djgrasss/MARK/literature/Brainstorming session 2.jpg

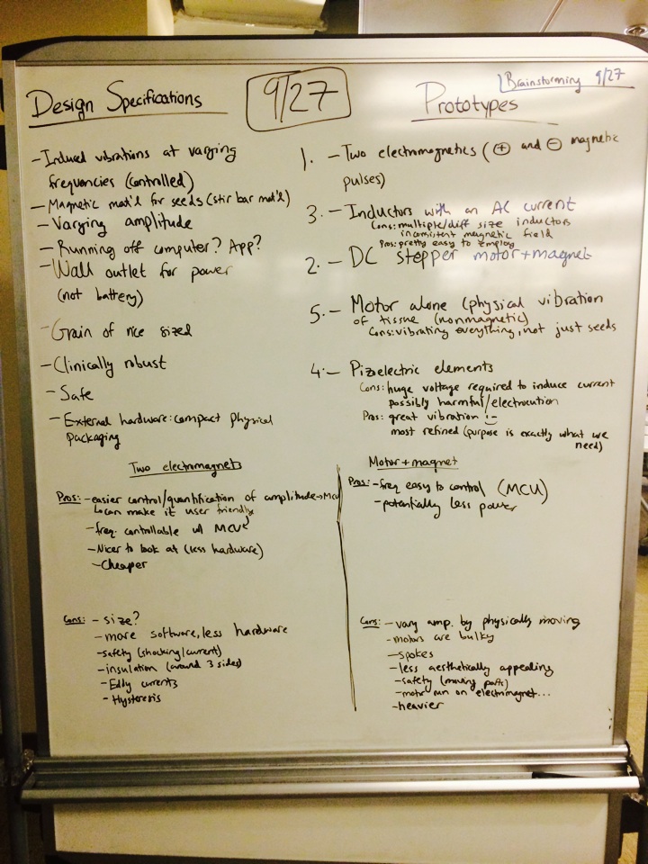
literature/Brainstorming session 2.jpg
