djgrasss/MARK/literature/20141203_085435.jpg

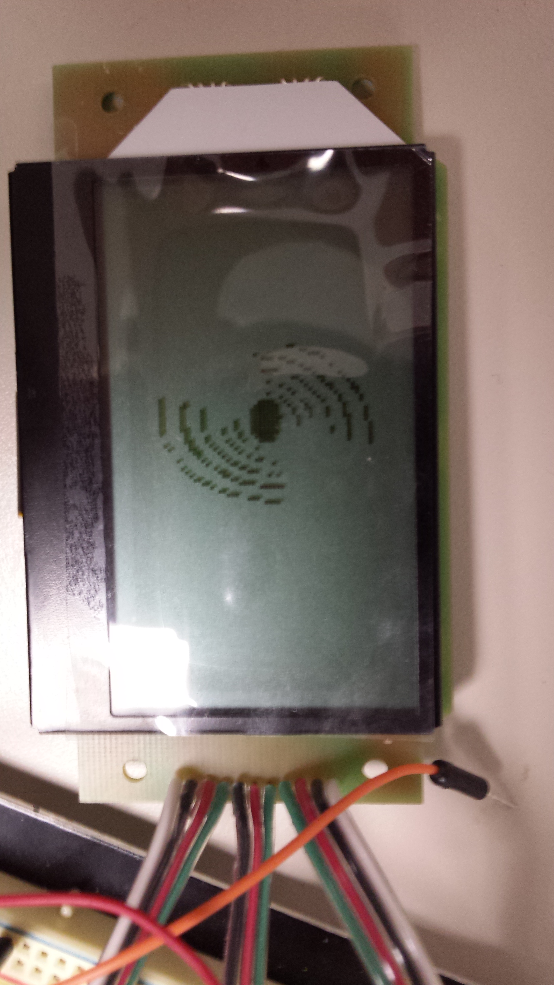
literature/20141203_085435.jpg
