djgrasss/MARK/README.md

MARK
====

Multi-Spectral Prostate Brachyseed Oscillator
-------------------------------------------

Team Roles
----------
 * Software: Michael
 * Testing: Ananya
 * Hardware: Rhea
 * Physical Design: Karthika
