djgrasss/MARK/RelevantLiterature.md

Relevant Literature
===================

Some literature worth considering in your research of the clinical motivation
for this project:

 * Chen, S., Fatemi, M., & Greenleaf, J. F. (2002). Remote measurement of
   material properties from radiation force induced vibration of an embedded
   sphere. Journal of the Acoustical Society of America, 112(3), 884-889.
