djgrasss/MARK/EMF strength analysis data (Design).xlsx

 | Seed distance from magnet (cm) | Observations about seed movement | Current through magnet (A) | mesured EMF field strength (mT) | Calculated field strength (mT)
Trial 1 | 3
Trial 2 | 3
Trial 3 | 3
Average
Trial 1 | 4
Trial 2 | 4
Trial 3 | 4
Average
Trial 1 | 5
Trial 2 | 5
Trial 3 | 5
Average
Trial 1 | 6
Trial 2 | 6
Trial 3 | 6
Average
Trial 1 | 7
Trial 2 | 7
Trial 3 | 7
Average
Trial 1 | 8
Trial 2 | 8
Trial 3 | 8
Average
Trial 1 | 9
Trial 2 | 9
Trial 3 | 9
Average
Trial 1 | 10
Trial 2 | 10
Trial 3 | 10
Average
Trial 1 | 11
Trial 2 | 11
Trial 3 | 11
Average
Trial 1 | 12
Trial 2 | 12
Trial 3 | 12
Average
Trial 1 | 13
Trial 2 | 13
Trial 3 | 13
Average
Trial 1 | 14
Trial 2 | 14
Trial 3 | 14
Average
Trial 1 | 15
Trial 2 | 15
Trial 3 | 15
Average
