djgrasss/MARK/Testing/EMF strength analysis data (Design).xlsx

 | Seed distance from magnet (cm) | Observations about seed movement | Current through magnet (A) | measured EMF field strength (mT) | Calculated field strength (T) | Calculated field strength (mT) | Ratio (measured/calculated)
Trial 1 | 0.5 |  | 1.9 | 3.9 | 0.0025 | 2.5 | 1.56 | Frequency: 5 Hz
Trial 2 | 0.5 |  | 1.92 | 3.92 | 0.0025 | 2.5 | 1.568 | Voltage: 6.02 V
Trial 3 | 0.5 |  | 1.96 | 3.86 | 0.0025 | 2.5 | 1.544
Average | 0.5 |  | 1.926666667 | 3.893333333 | 0.0025 | 2.5 | 1.557333333
Trial 1 | 1 |  | 1.9 | 3.8 | 0.0016 | 1.6 | 2.375
Trial 2 | 1 |  | 1.92 | 3.6 | 0.0017 | 1.7 | 2.117647059
Trial 3 | 1 |  | 1.96 | 3.4 | 0.0017 | 1.7 | 2
Average | 1 |  | 1.926666667 | 3.6 | 0.0017 | 1.666666667 | 2.16
Trial 1 | 1.5 |  | 1.9 | 2.48 | 0.0011 | 1.1 | 2.254545455
Trial 2 | 1.5 |  | 1.92 | 2.35 | 0.0011 | 1.1 | 2.136363636
Trial 3 | 1.5 |  | 1.96 | 2.2 | 0.0011 | 1.1 | 2
Average | 1.5 |  | 1.926666667 | 2.343333333 | 0.0011 | 1.1 | 2.13030303
Trial 1 | 2 |  | 1.9 | 2.1 | 0.0007 | 0.7 | 3
Trial 2 | 2 |  | 1.92 | 2.2 | 0.0008 | 0.8 | 2.75
Trial 3 | 2 |  | 1.96 | 2.01 | 0.0008 | 0.8 | 2.5125
Average | 2 |  | 1.926666667 | 2.103333333 | 0.0008 | 0.7666666667 | 2.743478261
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
