djgrasss/MARK/Design Enclosure Draft.JPG

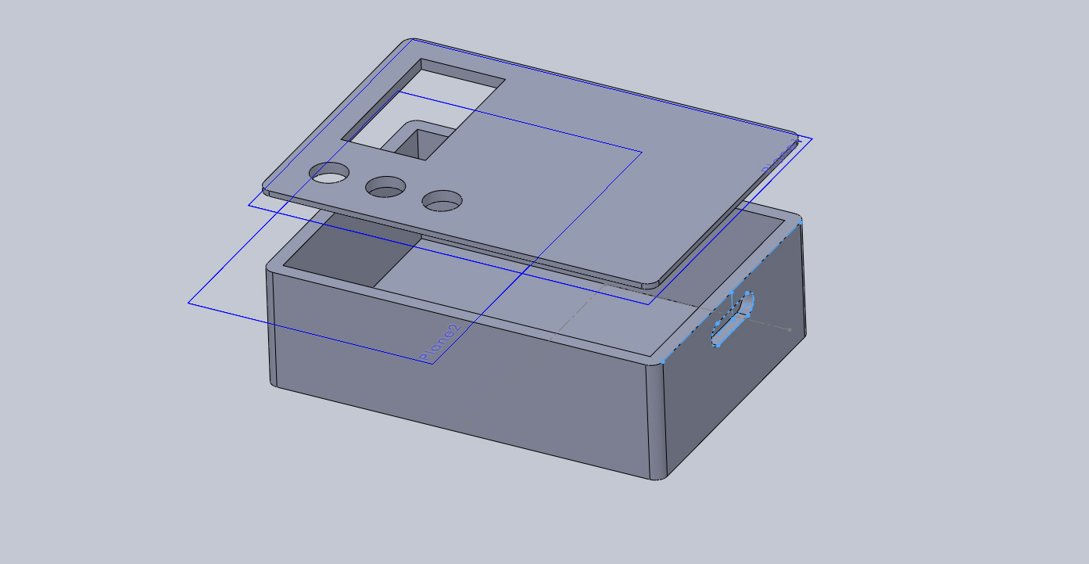
Design Enclosure Draft.JPG
