djgrasss/MARK/DigitalPot2Arduino.jpg

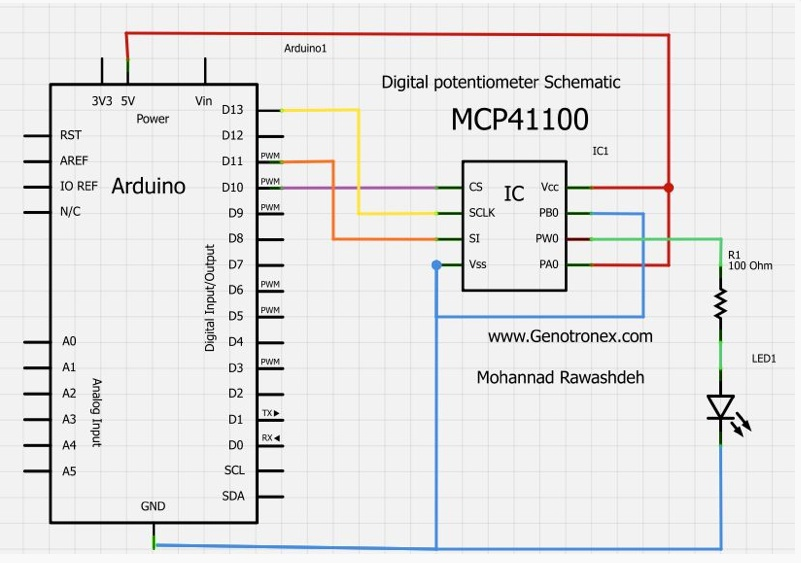
DigitalPot2Arduino.jpg
