djgrasss/MARK/DigitalPot.jpg

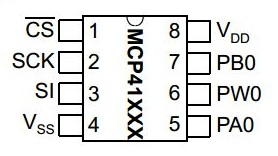
DigitalPot.jpg
