djgrasss/MARK/Flowcharts/jpeg images of flowcharts/draw_backlight.PNG

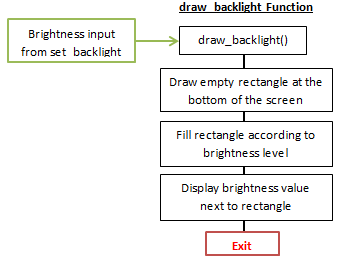
Flowcharts/jpeg images of flowcharts/draw_backlight.PNG
