djgrasss/MARK/Flowcharts/jpeg images of flowcharts/draw_cursor.PNG

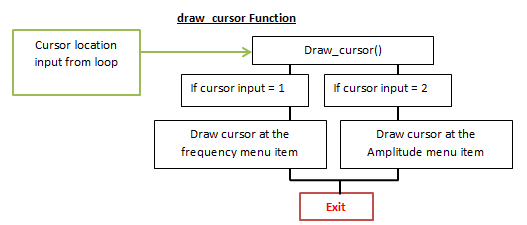
Flowcharts/jpeg images of flowcharts/draw_cursor.PNG
