djgrasss/MARK/Flowcharts/jpeg images of flowcharts/draw_frequency_and_amp.PNG

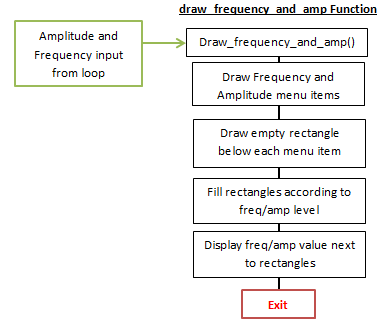
Flowcharts/jpeg images of flowcharts/draw_frequency_and_amp.PNG
