djgrasss/MARK/Flowcharts/jpeg images of flowcharts/general flowchart.PNG

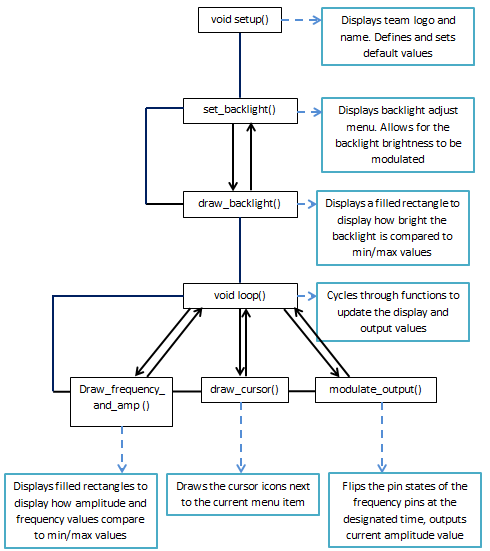
Flowcharts/jpeg images of flowcharts/general flowchart.PNG
