djgrasss/MARK/Flowcharts/jpeg images of flowcharts/loop.PNG

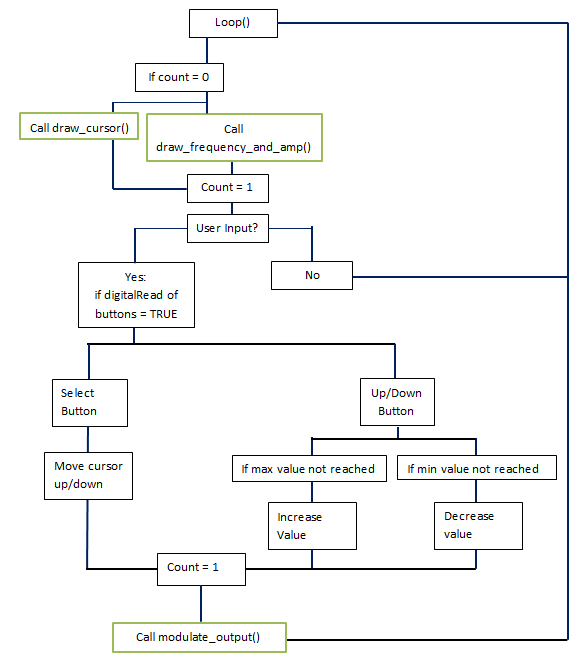
Flowcharts/jpeg images of flowcharts/loop.PNG
