djgrasss/MARK/Flowcharts/jpeg images of flowcharts/modulate_output.PNG

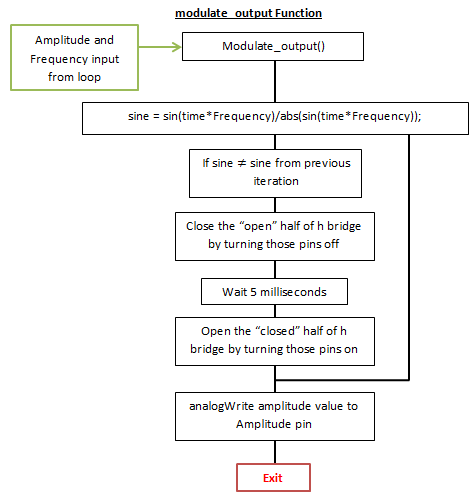
Flowcharts/jpeg images of flowcharts/modulate_output.PNG
