djgrasss/MARK/Flowcharts/jpeg images of flowcharts/set_backlight.PNG

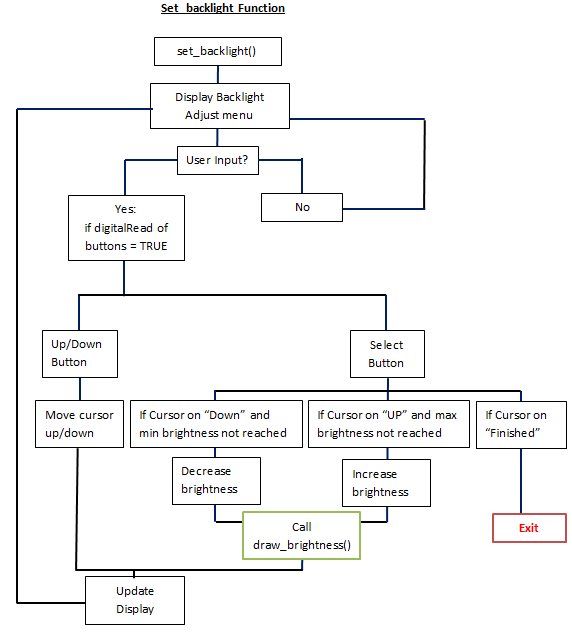
Flowcharts/jpeg images of flowcharts/set_backlight.PNG
