djgrasss/MARK/literature/20141203_085404.jpg

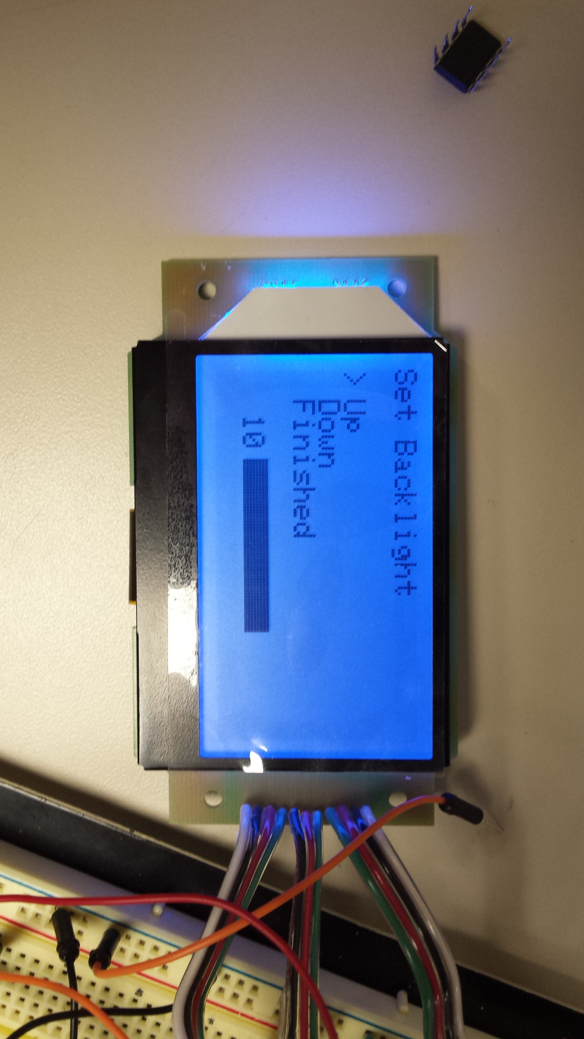
literature/20141203_085404.jpg
