djgrasss/MARK/literature/20141203_085438.jpg

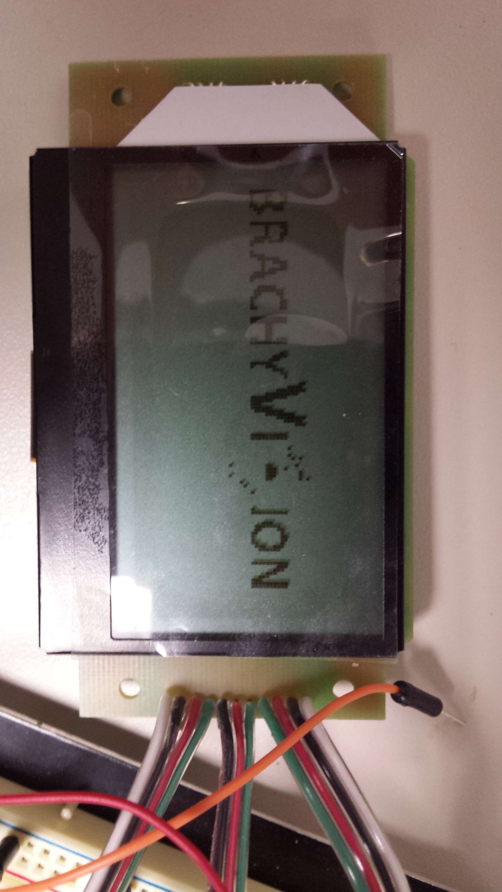
literature/20141203_085438.jpg
