djgrasss/MARK/literature/20141203_085441.jpg

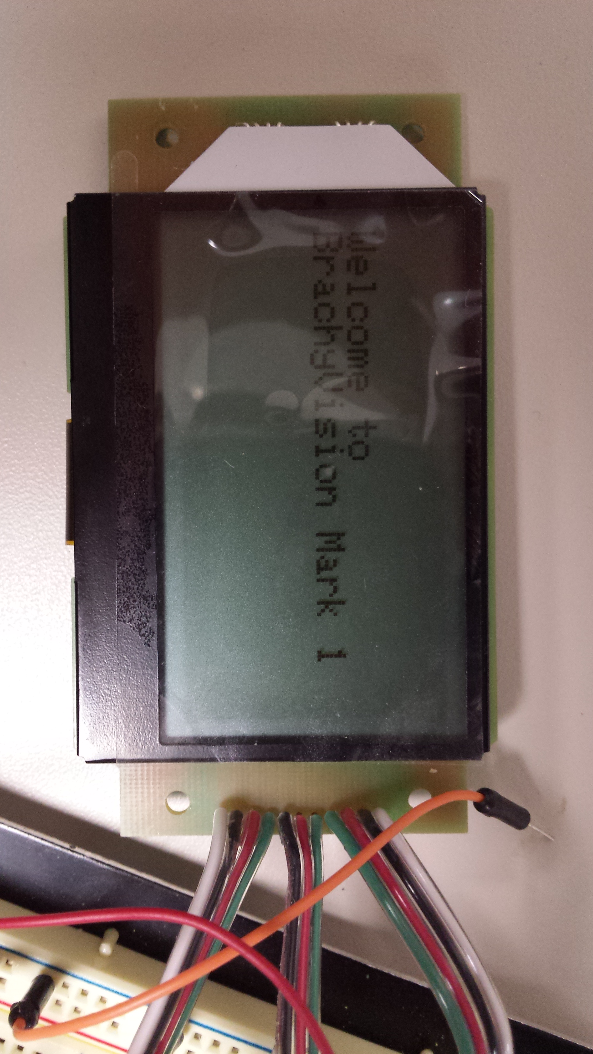
literature/20141203_085441.jpg
