djgrasss/MARK/literature/20141203_085541.jpg

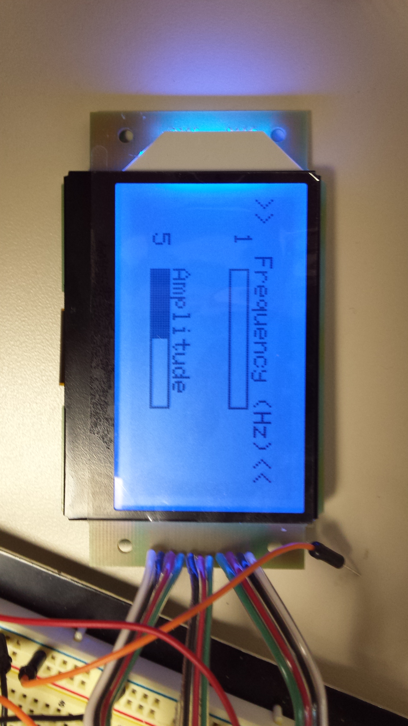
literature/20141203_085541.jpg
