djgrasss/MARK/literature/New LCD Screen.PNG

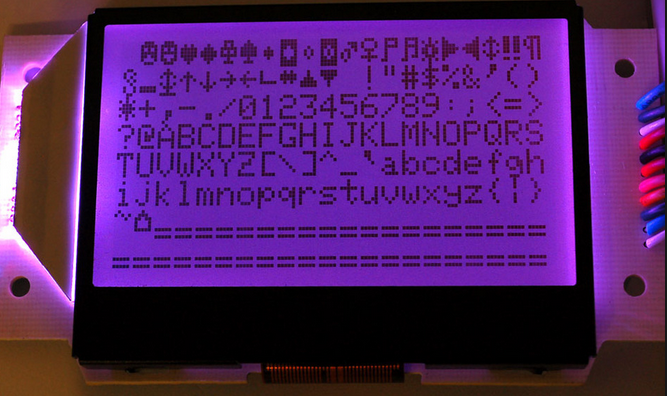
literature/New LCD Screen.PNG
