djgrasss/MARK/Software Flowchart.PNG

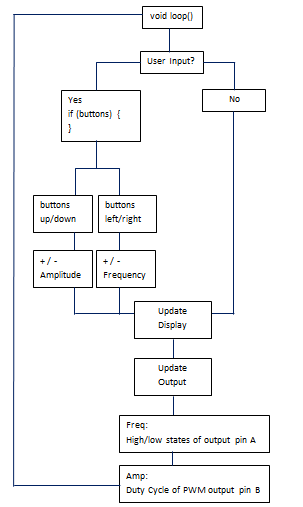
Software Flowchart.PNG
