djgrasss/MARK/Team MARK probe 2.JPG

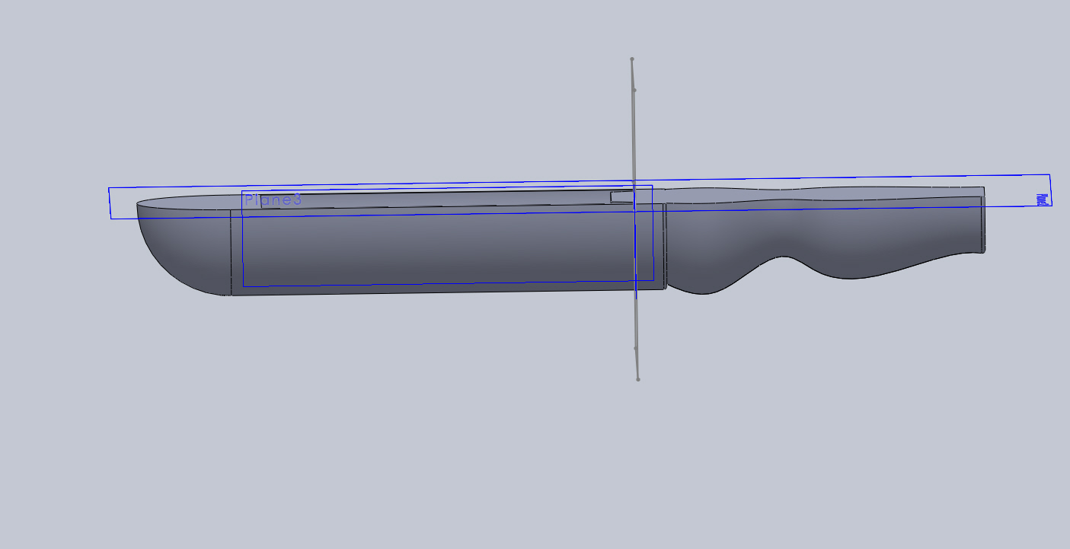
Team MARK probe 2.JPG
