djgrasss/MARK/Team MARK probe 3.JPG

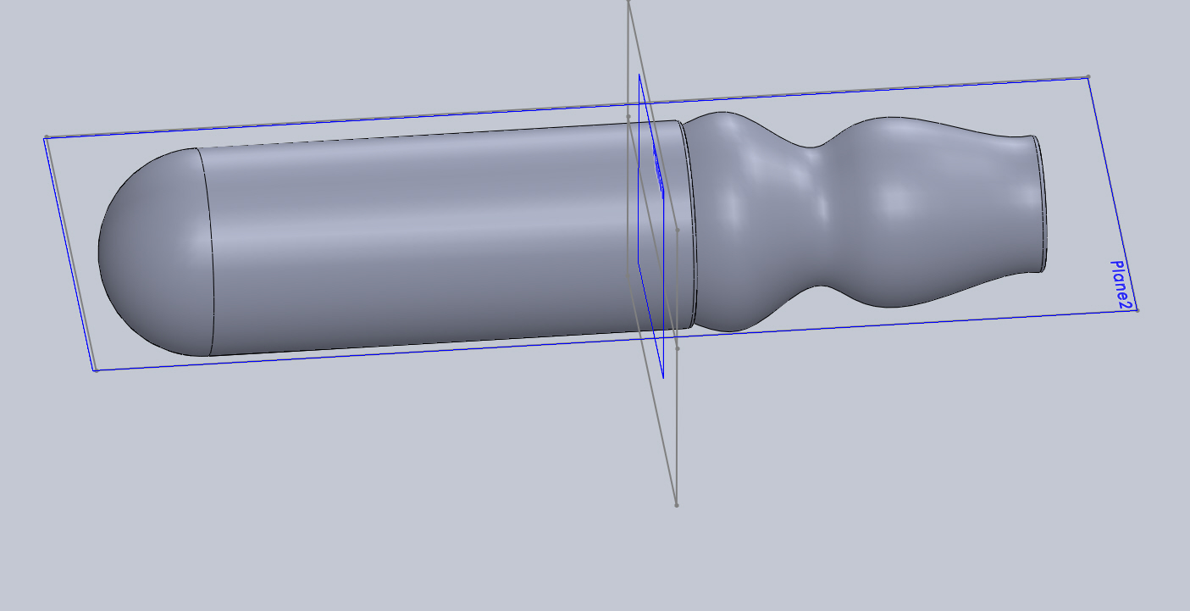
Team MARK probe 3.JPG
