djgrasss/MARK/Team MARK probe.JPG

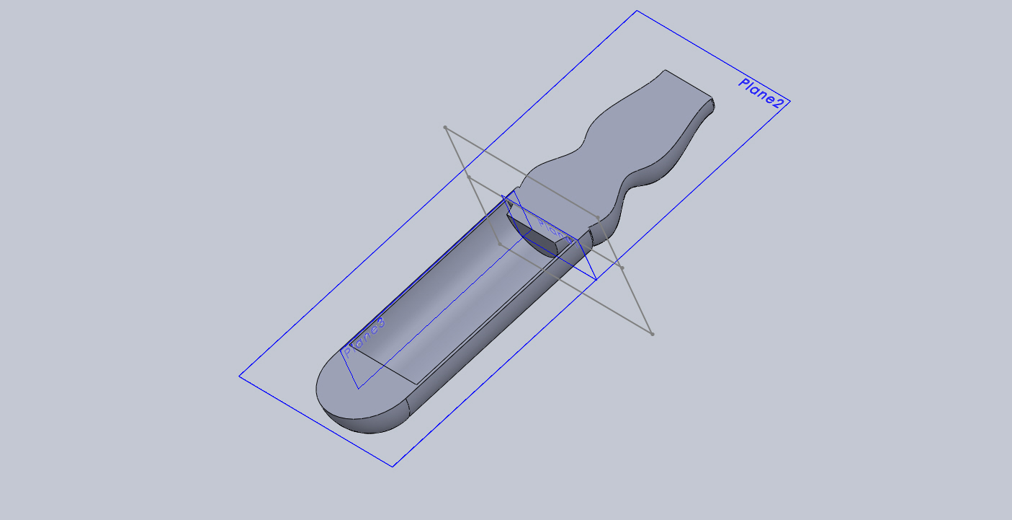
Team MARK probe.JPG
