djgrasss/MARK/Component Order Form.xlsx

Name | Karthika Raja |  |  |  |  |  |  |  | Instructions
Group | Team MARK |  |  |  |  |  |  |  | Orders must be submitted by email by 8pm Thursday evening to nbb5@duke.edu to be processed with the weekly Friday order
Date | 2014-10-09 |  |  |  |  |  |  |  | Preferred vendor is Mouser. Backups are Newark and Digikey. Please check these first for your component - arrangements can be made if your part can only come from another source (e.g. your main sensor)
Vendor | Quantity | Part number | Part Description | Package | Price | Extended Price | URL (if not Mouser) | Notes | When ordering ICs, be particularly careful about package - size of chip and type of pins
Adafruit | 1 | 250 | Graphic ST7565 Positive LCD (128x64) |  | $17.50 | $17.50 | http://www.adafruit.com/products/250 |  | Include units for quantity where necessary (5 resistors vs 5 packs of 25 resistors)
Stirbars.com | 1 pack of 10 bars | SBM-0502-MIC | PTFE Stir Bars - 5 mm x 2mm |  | $26.00 | $26.00 | http://www.stirbars.com/list.php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 |  | Choose the right price for the quantity you are ordering - most companies offer bulk discounts
Stirbars.com | 1 pack of 10 bars | SBM-0303-MIC | PTFE Stir Bars - 3 mm x 3 mm |  | $26.00 | $26.00 | http://www.stirbars.com/list.php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 |  | Extended price is the quantity * price
Mouser | 1 pack 10 potentiometer | 652-3310C-001-204L (http://www.mouser.com/Search/ProductDetail.aspx) | Potentiometers 9mm 200Kohms Single Cup |  | $1.34 | $13.40 |  |  | Include any other necessary notes for Matt to process your order
Heat Sink Factory | 1 |  | AC to DC Adapter - 110V AC to 5V DC Converter w/ Standard 4 Pin (500mA Max) (http://www.heatsinkfactory.com/) |  | $10.75 | $10.75 | http://www.heatsinkfactory.com/ac-to-dc-adapter-110v-ac-to-5v.html
