djgrasss/MARK/Design Enclosure Draft.SLDPRT

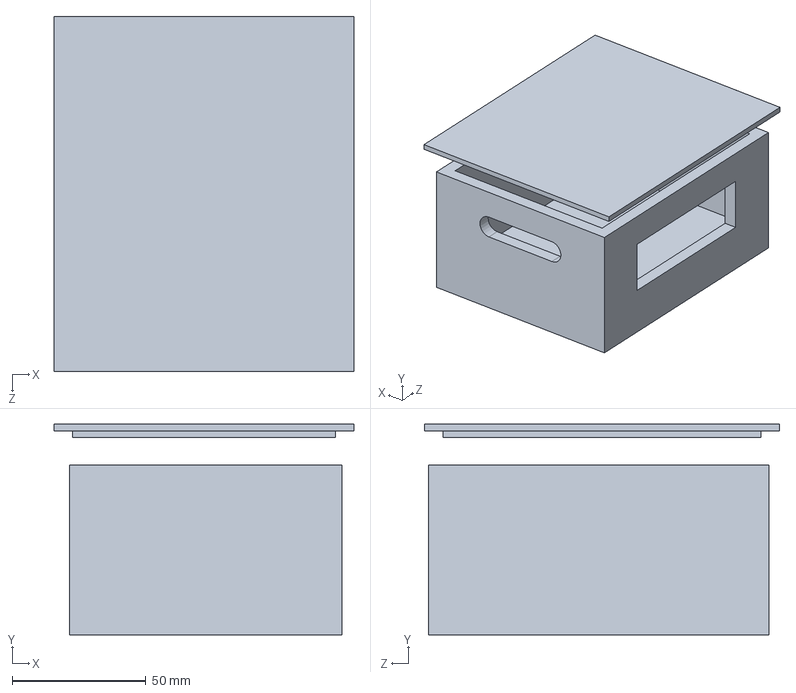
[picture p35: CAD file, 2014-10-10]
Design Enclosure Draft.SLDPRT
111.8 x 78.7 x 132.5 mm
