djgrasss/MARK/FINAL CAD Drawings/Team MARK Probe Part 1.SLDPRT

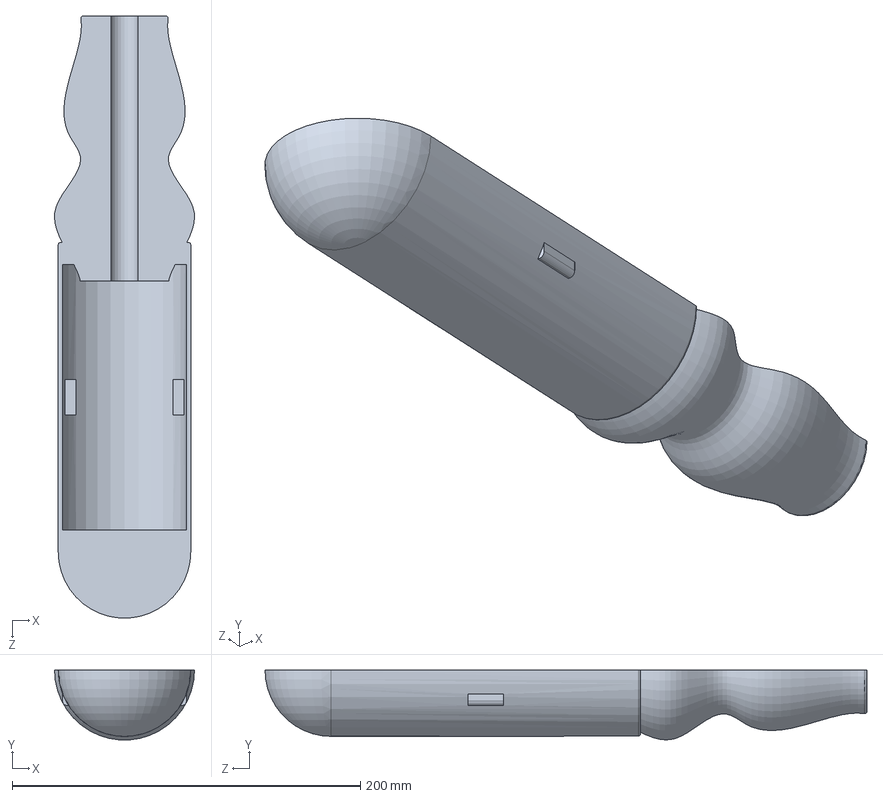
[picture p36: CAD file, 2014-11-16]
FINAL CAD Drawings/Team MARK Probe Part 1.SLDPRT
80.5 x 40.1 x 345.9 mm
