djgrasss/MARK/Design Probe Draft.SLDPRT

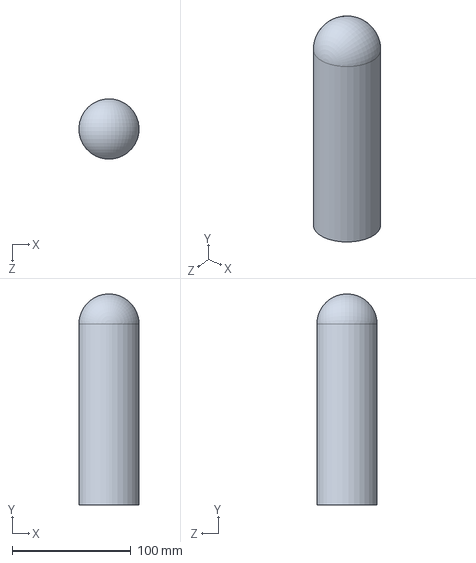
[picture p37: CAD file, 2014-10-10]
Design Probe Draft.SLDPRT
50.7 x 177.7 x 50.8 mm
