djgrasss/MARK/FINAL CAD Drawings/Design Enclosure Draft.SLDPRT

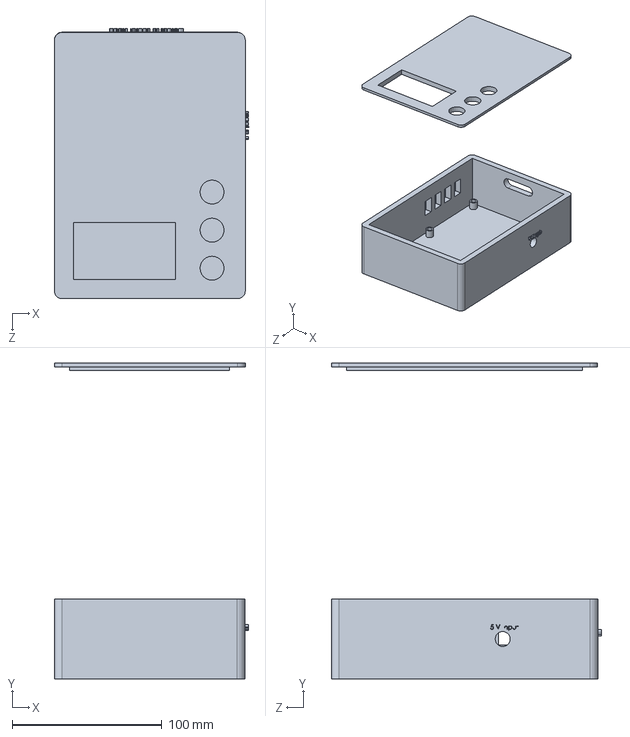
[picture p38: CAD file, 2014-11-16]
FINAL CAD Drawings/Design Enclosure Draft.SLDPRT
129.5 x 210.8 x 180.3 mm
