djgrasss/MARK/FINAL CAD Drawings/Team MARK probe.SLDPRT

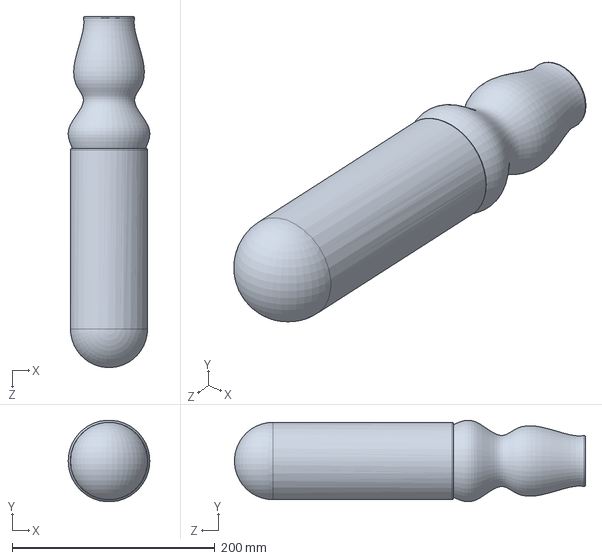
[picture p39: CAD file, 2014-11-12]
FINAL CAD Drawings/Team MARK probe.SLDPRT
80.5 x 80.2 x 345.8 mm
