djgrasss/MARK/IndianFlagMagnet.SLDPRT

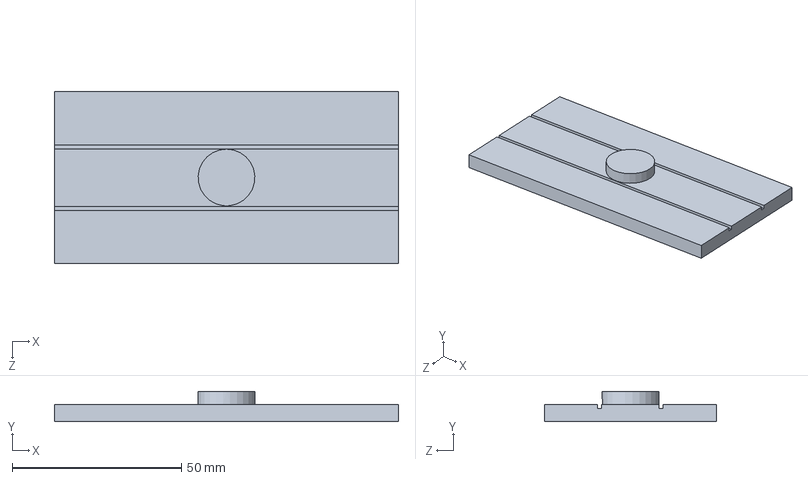
[picture p40: CAD file, 2014-10-08]
IndianFlagMagnet.SLDPRT
101.6 x 8.89 x 50.8 mm
