djgrasss/MARK/Dome Magnet.SLDPRT

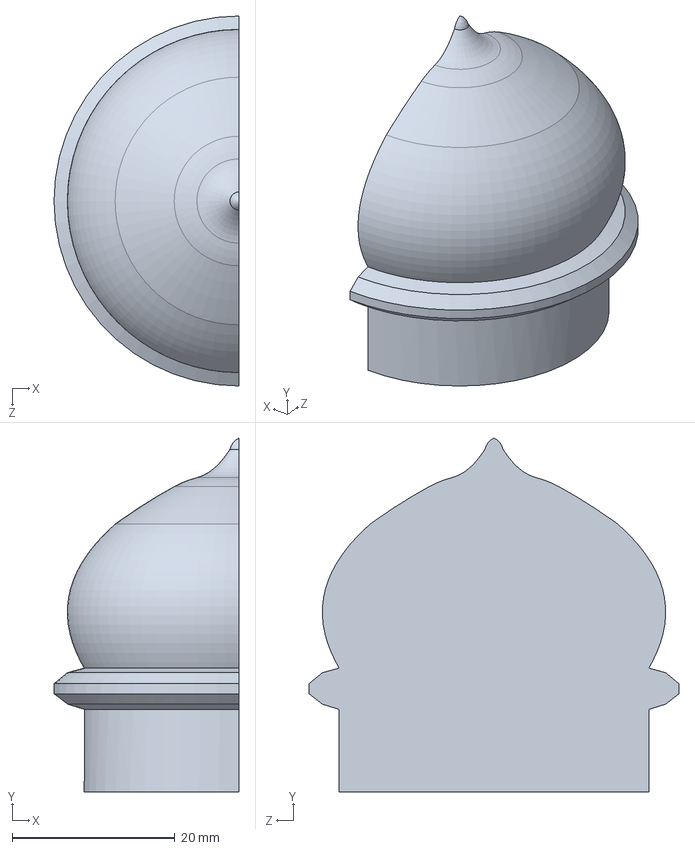
[picture p41: CAD file, 2014-10-08]
Dome Magnet.SLDPRT
22.8 x 43.6 x 45.5 mm
