djgrasss/MARK/Testing -- Magnet + Beads.xlsx

Sheet: Sheet1
Distance from magnet | Current for movement | Distance along magnet | Current for Movement | Trial | ** beads are parallel to magnet
5 cm | 0.31 A | 40 cm | 0.31 A | 1 | ** every 0.15 cm interval
 |  | 60 cm |  |  | ** measuring from the center of magnet
 |  | 100 cm
 |  | 120 cm
5 cm | 0.55 A | 20 cm | 0.55 A
 |  | 40 cm
5 cm | 0.86 A | 80 cm | 0.86 A
5 cm

Sheet: Sheet2
Distance from magnet center | Current for movement | Distance along magnet | Trial | ** beads are perpendicular to magnet
TRIAL 1
5 cm | 0.31 A | 20 cm | 1
5 cm |  | 40 cm
5 cm |  | 60cm
5 cm |  | 80 cm
5 cm | 1.15 A | 20 cm
5 cm |  | 80 cm
5 cm |  | 100 cm
5 cm | 1.4 A |  |  | ** overload
TRIAL 2
5 cm | 0.3 A | 60 | 2
5 cm |  | 80
5 cm | 0.42 | 20
5 cm |  | 40
5 cm | 1.01 | 100
5 cm |  | 20
5 cm | 1.4 A |  |  | ** overload
TRIAL 3
5 cm | 0.16 A | 20cm | 3
5 cm |  | 40cm
5 cm | 0.3 A | 60 cm
5 cm |  | 80cm
5 cm |  | 100 cm
5 cm | 0.77 A | 80 cm
5 cm
TRIAL 1
6 cm | 0.6 A | 20
6 cm |  | 40
6 cm |  | 60
6 cm |  | 80
6 cm |  | 100
6 cm
TRIAL 2
6 cm | 0.24A | 40
6 cm |  | 60
6 cm |  | 80
6 cm | 0.4 A | 100
6 cm | 0.72A | 20
6 cm | 0.99 A | 40 moved more
6 cm
TRIAL 3
6 cm | 0.31A | 40
6 cm |  | 60
6 cm | 0.47A | 80
6 cm |  | 100
6 cm |  | 120
6 cm | 0.8A | 100
6 cm |  | 120
TRIAL 1
7 cm | 0.48 A | 20
7 cm |  | 40
7 cm |  | 60
7 cm |  | 80
7 cm |  | 100
7 cm | 1.4 A | 120
7 cm
7 cm
TRIAL 2
7 cm | 0.23A | 20
7 cm | 0.4A | 40
7 cm |  | 60
7 cm |  | 80
7 cm |  | 100
7 cm | 0.56A | 20
7 cm | 1.4 A | 120
7 cm
TRIAL 3
7 cm | 0.24 | 100
7 cm | 0.37 | 20
7 cm |  | 40
7 cm |  | 60
7 cm |  | 80
TRIAL 1
8 cm | 0.55 | 20
8 cm |  | 40
8 cm |  | 80
8 cm | 0.87 | 80
8 cm |  | 100
8 cm |  | 120
8 cm | 1.39 | 80 move more
8 cm |  | 100 move more
TRIAL 2
8 cm | 0.4A | 80
8 cm | 0.65 | 40
8 cm |  | 60
8 cm |  | 80
8 cm | 0.89 | 20
8 cm |  | 100
8 cm | 1.3 | 120
TRIAL 3
8 cm | 0.48 | 40
8 cm |  | 60
8 cm |  | 80
8 cm | 0.77 | 20
8 cm |  | 40
8 cm |  | 60
8 cm |  | 80
8 cm |  | 100
8 cm | 1.4 | 120
TRIAL 1
9 cm | 0.16 | 60
9 cm | 0.37 | 40
9 cm | 0.5 | 20
9 cm |  | 40
9 cm |  | 60
9 cm |  | 80
9 cm |  | 100
TRIAL 2
9 cm | 0.48 | 40
9 cm |  | 60
9 cm |  | 80
9 cm | 0.9 | 40
9 cm |  | 60
9 cm |  | 80
9 cm |  | 100
9 cm | 1.21 | 20
TRIAL 3
9 cm | 0.58 | 40
9 cm |  | 60
9 cm |  | 80
9 cm | 1.1 | 20
9 cm |  | 40
9 cm |  | 60
9 cm |  | 80
9 cm |  | 100
TRIAL 1
10 cm | 0.46 | 80
10 cm | 0.79 | 20
10 cm |  | 40
10 cm |  | 60
10 cm |  | 80
10 cm | 1.28 | 100
10 cm |  | 120
TRIAL 2
10 cm | 0.7 | 40
10 cm |  | 60
10 cm |  | 80
10 cm | 0.88 | 100
10 cm |  | 120
10 cm | 1.07 | 20
10 cm |  | 40
TRIAL 3
10 cm | 0.69 | 40
10 cm |  | 60
10 cm |  | 80
10 cm | 0.98 | 100
10 cm | 1.12 | 20
10 cm | 1.4 | 60
