djgrasss/MARK/Testing/Amplitude modulation testing data.xlsx

Amplitude setting | Measured EMF (mT) |  | Repeated: | Amplitude setting | Measured EMF (mT) | Frequency: 5 Hz
0 | 0.02 |  |  | 0 | 0.06 | Voltage: 6V
0.5 | 0.06 |  |  | 0.5 | 0.07 | Magnet to Gaussmeter probe distance: 3 cm
1 | 0.08 |  |  | 1 | 0.1 | Amp setting of 0-5, we're going to go up in increments of 0.5
1.5 | 0.12 |  |  | 1.5 | 0.14
2 | 0.12 |  |  | 2 | 0.13 | Make sure gaussmeter tip is perpendicular to field lines
2.5 | 0.13 |  |  | 2.5 | 0.19
3 | 0.22 |  |  | 3 | 0.43 | reading will fluctuate b/c oscillating mag field, so record highest
3.5 | 0.46 |  |  | 3.5 | 0.52
4 | 0.56 |  |  | 4 | 0.62
4.5 | 0.98 |  |  | 4.5 | 0.9
5 | 1.12 |  |  | 5 | 1.64
 |  | 0.02 | 0.06 | 0.08
 |  | 0.06 | 0.07 | 0.1
