djgrasss/MARK/Testing/Power testing data.xlsx

Trial | Vmax (V) | Vrms (V) | Imax (I) | Irms (I) | Power (watts)
1 | 3.03 | 2.142533547 | 0.6 | 0.4242640687 | 0.909 |  | Distance between seed and electromagnet: 2 cm
2 | 3.03 | 2.142533547 | 0.55 | 0.3889087297 | 0.83325 |  | Frequency: | 5 Hz
3 | 3 | 2.121320344 | 0.56 | 0.3959797975 | 0.84
Average | 3.02 | 2.135462479 | 0.57 | 0.4030508653 | 0.86075 |  | start at 3V, increase by increments of 0.5V
1 | 3.5 | 2.474873734 | 0.82 | 0.5798275606 | 1.435
2 | 3.5 | 2.474873734 | 0.87 | 0.6151828996 | 1.5225 |  | start in color mode to see where motion is. when there's movement, there will be color, and put in m-mode to actually get picture from which we can get velocity
3 | 3.5 | 2.474873734 | 0.85 | 0.601040764 | 1.4875
Average | 3.5 | 2.474873734 | 0.8466666667 | 0.5986837414 | 1.481666667
1 | 4.04 | 2.856711396 | 1.04 | 0.7353910524 | 2.1008 | started to see small wiggles
2 | 4.04 | 2.856711396 | 1.09 | 0.7707463915 | 2.2018
3 | 4.05 | 2.863782464 | 1.07 | 0.7566042559 | 2.16675 |  | Imax values are the maximum currents seen on the power supply
Average | 4.043333333 | 2.859068419 | 1.066666667 | 0.7542472333 | 2.15645
1 | 4.52 | 3.196122651 | 1.25 | 0.8838834765 | 2.825
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
