djgrasss/MARK/(list of files, drawings)

Other design files:
Hardware/Harware_PCBlayout.dip
Hardware/MARK_HardwareSchematic_V2.dch
HardwareSchematic_V1.dch
