djgrasss/MARK/(commit log)

2014-10-08 Team MARK SolidWorks Magnet
    Team MARK SolidWorks Magnet
    [Dome Magnet.SLDPRT]
2014-10-08 Indian Flag Magnet
    Solid works file for magnet
    [IndianFlagMagnet.SLDPRT]
2014-10-09 Team MARK Component Order Form
    Team MARK Component Order Form - 10/9/14
    [Component Order Form.xlsx]
2014-10-10 Physical Design Draft
    Physical Design Draft - 10/9/14
    [Design Enclosure Draft.SLDPRT, Design Probe Draft.SLDPRT]
2014-10-24 Update 1 Presentation
    Added powerpoint for update 1 presentation. fixed software flowchart
    [BrachySeed_Oscillator.ino]
2014-10-31 Completed Software v1.0
    completed software, and added recording of current amplitude necessary
    to attract stir bars at different distances
    [Testing -- Magnet + Beads.xlsx]
2014-11-03 Hardware Schematic- DipTrace
    [Mark hardware.dch]
2014-11-07 Team MARK Probe View 1
    Team MARK Probe View 1
2014-11-07 Team MARK Probe View 2
    Team MARK Probe View 2
2014-11-07 Team MARK Probe View 3
    Team MARK Probe View 3
2014-11-09 Team MARK Design Enclosure Draft
    Team MARK Design Enclosure Draft
2014-11-10 Completed V1.0 of the code. Functional for the ARDUINO LCD shield
2014-11-11 Brachyseed Oscillator RC & KR
    Code is the same as original Brachyseed_Oscillator.ino except for the
    two frequency pins are in phase with each other due to being modulated
    by both TIP120 and TIP127
    [Brachyseed_Oscillator_RC_KR.ino]
2014-11-12 SLDPRT Files and JPEGs - Pre-Final
    SLDPRT Files and JPEGs - Pre-Final Device Enclosure and Probe
    [Design Enclosure Draft.SLDPRT, Team MARK probe.SLDPRT]
2014-11-14 Hardware Dip Trace_V1
    [HardwareSchematic_V1.dch]
2014-11-14 update schematic with notes
    [HardwareSchematic_V1.dch, Mark hardware.dch]
2014-11-16 EMF strength analysis data
    excel document for inputting data into for the electromagnetic field
    strength analysis
    [EMF strength analysis data (Design).xlsx]
2014-11-16 FINAL CAD DRAWINGS!
    FINAL CAD DRAWINGS!
    [Team MARK Probe Part 1.SLDPRT]
2014-11-16 Karthika Raja - Final CAD Drawings
    Karthika Raja - Final CAD Drawings (Deliverables)
    [Design Enclosure Draft.SLDPRT, Team MARK Probe Part 1.SLDPRT, Team MARK probe.SLDPRT]
2014-11-17 MARK_HardwareSchematic
    Deliverable for 11/17/14
    [MARK_HardwareSchematic_V2.dch]
2014-11-17 Revert "MARK_HardwareSchematic"
    This reverts commit c6ebafd00b1ff2957f518d572a08f903bf9a0776.
    [MARK_HardwareSchematic_V2.dch]
2014-11-17 MARK_Hardware
    Hardware Schematic for 11/17/2014
    [MARK_HardwareSchematic_V2.dch]
2014-11-18 Updated Schematic based on feedback
    Labeled the signals from the Arduino to transistors. Labeled Arduino
    pins. Put Resistor values in the "Value" field.
    [MARK_HardwareSchematic_V2.dch]
2014-11-18 Digital Potentiometer to Arduino Connection
    Digital Potentiometer to Arduino Connection
2014-11-18 Digital Potentiometer Schematic
    Digital Potentiometer Schematic
2014-11-20 Created a better version of the menu screen. Does not utilize the user made menu library that the other versions does. Also, has a much better implementation method for oscillating the digital state 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
    [BrachySeed_Best_Version.ino]
2014-11-25 removed unnecessary comments in the code. Added flowcharts for all of the software
2014-11-26 Heat Sink on Hardware
    Heat Sink on Hardware
2014-11-26 11.24.14 Heat Sink
    11.24.14 Heat Sink
2014-12-01 Active LPF+Gain and Voltage Regulator
    Added the non inverting low pass filter with gain to the output of the
    PWM pin from the Arduino. Added the voltage regulator to the circuit
    [MARK_HardwareSchematic_V2.dch]
2014-12-01 PCB layout
    PCB layout currently includes all hardware: Arduino pins to H bridge,
    PWM Arduino pin to LPF+ amplifier and voltage regulator with pins to
    connect wires to the electromagnet
    [Harware_PCBlayout.dip]
2014-12-02 Updated PCB Board
    Routed connections
    [Harware_PCBlayout.dip, MARK_HardwareSchematic_V2.dch]
2014-12-02 Corrected routings- double layer
    Re-routed to prevent overlap. Board size increased.
    [Harware_PCBlayout.dip]
2014-12-02 H-bridge + Amplitude Regulation (No LCD screen ckt)
    Re-aligned the holes for mounting screws. Fixed some re-routing
    problems. Circuit without level shift (Screen circuit)
    [Harware_PCBlayout.dip]
2014-12-03 Updated Hardware
    Updated Hardware moved into a folder. Schematic has both amplitude and
    frequency control. PCB is done- All that is needed is a switch.
    [Harware_PCBlayout.dip, MARK_HardwareSchematic_V2.dch]
2014-12-03 Final PCB
    Finished PCB: Added in switch connections
    [Harware_PCBlayout.dip]
2014-12-03 Final PCB board
    Final PCB board. All connections are made. Includes on/off switch and
    buttons to control user inputs
    [Harware_PCBlayout.dip, MARK_HardwareSchematic_V2.dch]
2014-12-03 Final Board + Schematic
    Updated Schematic to include: H bridge, Amplitude Control, User Control
    buttons, LCD Screen pins, Level Shift
    [Harware_PCBlayout.dip, MARK_HardwareSchematic_V2.dch]
2014-12-04 Cleaned connections based on Feedback
    Autorouted to get cleaner wiring. Tried to minimize the lengths of
    connections in the layout. Need to still work on getting the ground to
    be connected around the board instead of through.
    [Harware_PCBlayout.dip, MARK_HardwareSchematic_V2.dch]
2014-12-04 Moved ground to edge. Increased trace width
    added a ground pin for the 12V power connector. Moved ground to the edge
    and tried to make traces go around the board. Increased 12V trace width
    to .1, Arduino traces to 0.2 and 12V to other components to 0.05 in
    [Harware_PCBlayout.dip]
2014-12-04 Changes made based on most recent feedback
    Increased annular ring size. Made all traces 0.03 in. Tried to not snake
    connections. Moved traces away from mounting holes.
    [Harware_PCBlayout.dip]
2014-12-04 Final board- for real
    Standardized all ring sizes. Increase size of vias. Made connections
    easier
    [Harware_PCBlayout.dip]
2014-12-04 READY TO PRINT
    [Harware_PCBlayout.dip]
2014-12-10 Delete Pre Final CAD Drawings
    Delete Pre Final CAD Drawings
    [Design Enclosure Draft.SLDPRT, Team MARK Probe Part 1.SLDPRT, Team MARK probe.SLDPRT]
2014-12-13 Testing
    Testing data files, pictures, and protocols.
    [Amplitude modulation testing data.xlsx, EMF strength analysis data (Design).xlsx, First Pass Test with Seeds data.xlsx, Power testing data.xlsx]
2014-12-13 Team MARK Final Report
    Team MARK Final Report
    [Design Enclosure Draft.SLDPRT, Team MARK Probe Part 1.SLDPRT, Team MARK probe.SLDPRT]
